zalmanlip/Camera-Trap/README.md

# Camera-Trap
refer to https://github.com/anamitradatta/Integrated-Camera-Trap for more details of the project

For info on work by me, email zalman9876@gmail.com with the subject line "Camera Trap"
