zalmanlip/Camera-Trap/Integrated-Camera-Trap-master/README.md

Integrated-Camera-Trap

Senior Design Project 2020 Team 15

Members: <br />
Anamitra Datta  <br />
Max Haimowitz <br />
Xiaoyang Pan <br />
Minting Chen <br />

Advisors: <br />
Professor Duncan Irschick: (https://www.bio.umass.edu/biology/about/directories/faculty/duncan-j-irschick) <br />
Professor David Schmidt: (https://mie.umass.edu/faculty/david-schmidt) <br />
Professor Marco Duarte (ECE SDP Advisor) : (https://ece.umass.edu/faculty/marco-duarte) <br />

http://www.ecs.umass.edu/ece/sdp/sdp20/team15/

Network of Raspberry Pis connected with Camera Modules to take synchronized pictures via WIFI using Message Query Telemetry Transport (MQTT) (Mosquitto) triggered by motion sensors

If you need access to this repository, contact me at my email address: anamitradatta@gmail.com and cc Professor Duncan 
Irschick and/or Professor David Schmidt and ask them to grant permission. Please provide your github username as well.
