zalmanlip/Camera-Trap/BOM.xlsx

 | Description | Source | Part number | QTY to Order | Price | Link | QTY per Unit | For one enclosure | cost for 1 enclosure | Enough to make
1 | High-Temperature Silicone Rubber Tubing for Air and Water - Soft, Durometer 35A, 1/8" ID, 1/4" OD, Opaque White | McMaster-Carr | 5236K506 | 1 | $13.70 | https://www.mcmaster.com/catalog/5236k506 | 10 | 2 | $2.74 | 5
2 | Heat-Set Inserts for Plastic, Brass, M2.5 x 0.45 mm, 5.9 mm Installed Length | McMaster-Carr | 94459A439 | 1 | $8.28 | https://www.mcmaster.com/catalog/94459a439 | 25 | 6 | $1.99 | 4
3 | 18-8 Stainless Steel Hex Head Screw, M4 x 0.7 mm Thread, 30 mm Long | McMaster-Carr | 91287A118 | 1 | $9.32 | https://www.mcmaster.com/catalog/91287a118 | 50 | 2 | $0.37 | 25
4 | 18-8 Stainless Steel Wing Nut,M4 x 0.7 mm Thread | McMaster-Carr | 94545A220 | 1 | $7.00 | https://www.mcmaster.com/catalog/94545a220 | 10 | 2 | $1.40 | 5
5 | General Purpose 18-8 Stainless Steel Washer,for M4 Screw Size, 4.300 mm ID, 8 mm OD | McMaster-Carr | 98689A113 | 1 | $2.86 | https://www.mcmaster.com/catalog/98689a113 | 100 | 4 | $0.11 | 25
6 | 3M Super Silicone Sealant, Model 8661, 3 oz. Tube | McMaster-Carr | 74955A53 | 1 | $13.22 | https://www.mcmaster.com/catalog/74955a53 | 1 | 0.1 | $1.32 | 10
7 | Black-Oxide Alloy Steel Socket Head Screw, M2.5 x 0.45 mm Thread, 4 mm Long | McMaster-Carr | 91290A099 | 1 | $10.45 | https://www.mcmaster.com/catalog/91290a099 | 50 | 6 | $1.25 | 8
8 | Partially Threaded Steel Stud, M3 x 0.50 mm Thread Size, 10 mm Long | McMaster-Carr | 97493A112 | 1 | $7.29 | https://www.mcmaster.com/catalog/97493a112 | 25 | 8 | $2.33 | 3
9 | Light-Duty Buckles for 1" Maximum Webbing Width, Sew-on, Plastic Feed Through Part number | McMaster-Carr | 29705T81 | 1 | $7.56 | https://www.mcmaster.com/catalog/29705t81 | 25 | 1 | $0.30 | 25
10 | Zinc-Plated Alloy Steel Socket Head Screw, M2 x 0.4 mm Thread, 5 mm Long | McMaster-Carr | 90128A177 | 1 | $12.40 | https://www.mcmaster.com/catalog/90128a177 | 100 | 6 | $0.74 | 16
11 | Shock-Absorbing Nylon Webbing, 1" Wide, 4 Feet Long, Black | McMaster-Carr | 3510T54 | 1 | $6.29 | https://www.mcmaster.com/catalog/3510t54 | 2 | 1 | $3.15 | 2
12 | HATCHBOX PLA 3D Printer Filament, Dimensional Accuracy +/- 0.03 mm, 1 kg Spool, 1.75 mm, White | Amazon |  | 1 | $22.99 | https://www.amazon.com/dp/B00J0GMMP6/ref=pe_386300_440135490_TE_item | 1 | 0.5 | $11.49 | 2
 |  |  |  |  |  |  |  | Per unit cost: | $27.21
 |  |  |  |  | h
