zalmanlip/Camera-Trap/CAD/Mount.SLDPRT

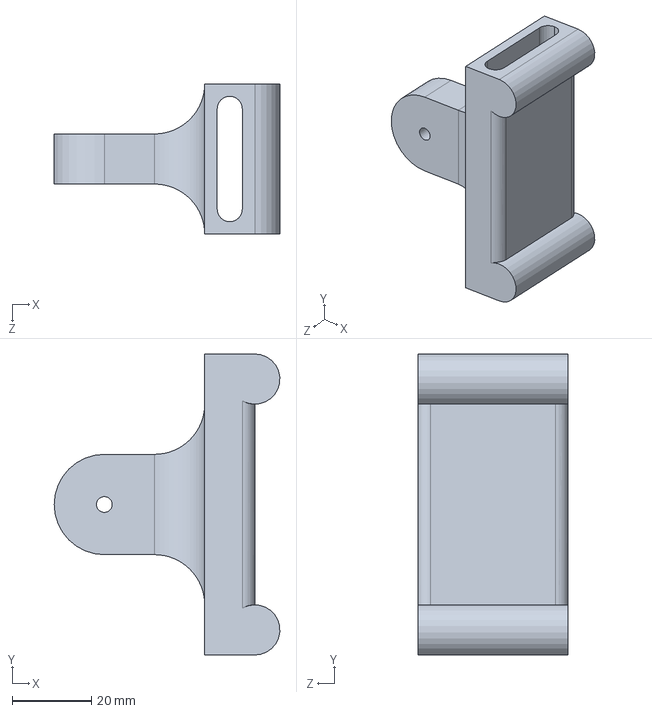
[picture p12: CAD file, 2021-12-16]
CAD/Mount.SLDPRT
57.1 x 76.2 x 38.1 mm
