zalmanlip/Camera-Trap/CAD/Swivel.SLDPRT

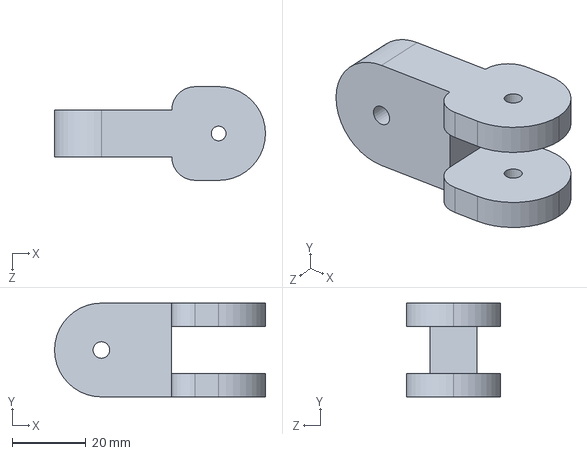
[picture p13: CAD file, 2021-12-16]
CAD/Swivel.SLDPRT
57.2 x 25.4 x 25.4 mm
