zalmanlip/Camera-Trap/CAD/HCSR501.step

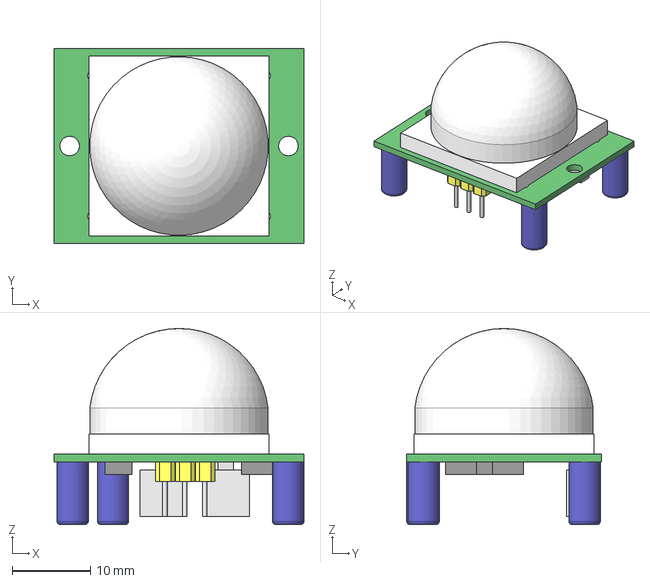
[picture p14: CAD file, 2021-12-16]
CAD/HCSR501.step
32.0 x 25.0 x 25.1 mm
