zalmanlip/Camera-Trap/CAD/Latch.SLDPRT

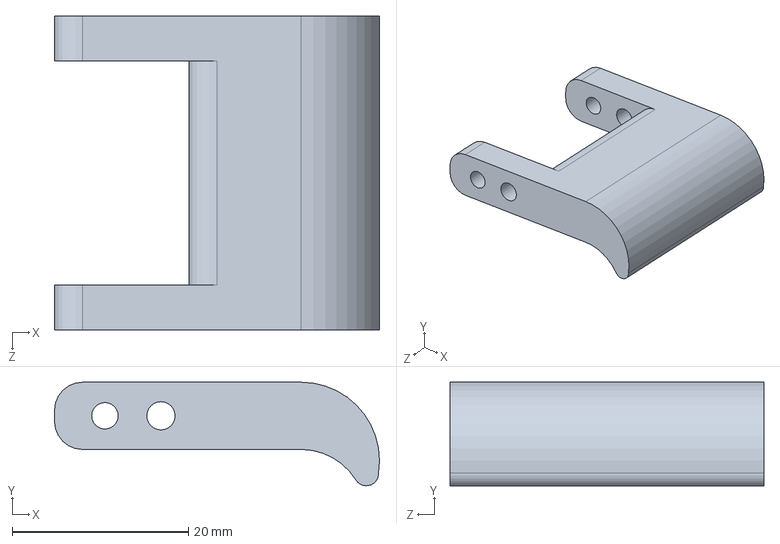
[picture p15: CAD file, 2021-12-16]
CAD/Latch.SLDPRT
36.8 x 11.7 x 35.6 mm
