zalmanlip/Camera-Trap/CAD/Camera Bracket.SLDPRT

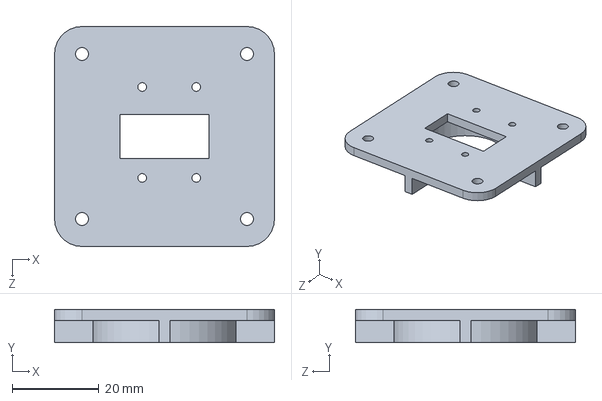
[picture p16: CAD file, 2021-12-16]
CAD/Camera Bracket.SLDPRT
50.8 x 7.62 x 50.8 mm
