zalmanlip/Camera-Trap/CAD/Lid.SLDPRT

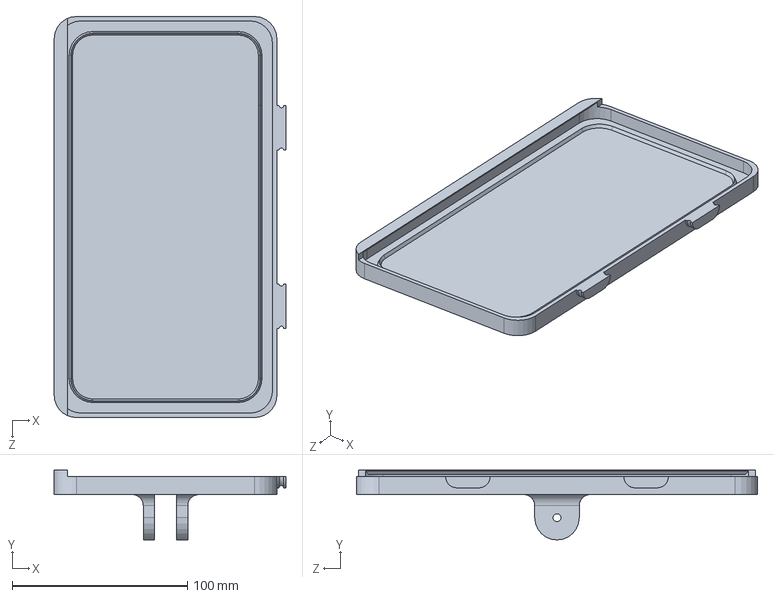
[picture p17: CAD file, 2021-12-16]
CAD/Lid.SLDPRT
132.1 x 39.9 x 228.6 mm
