zalmanlip/Camera-Trap/CAD/Separator.SLDPRT

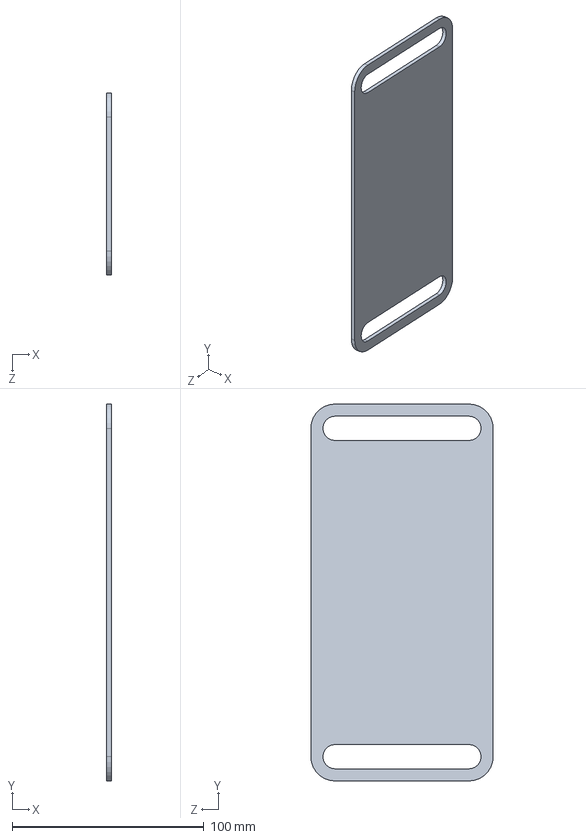
[picture p18: CAD file, 2021-12-16]
CAD/Separator.SLDPRT
2.54 x 196.9 x 95.2 mm
