zalmanlip/Camera-Trap/CAD/Hook.SLDPRT

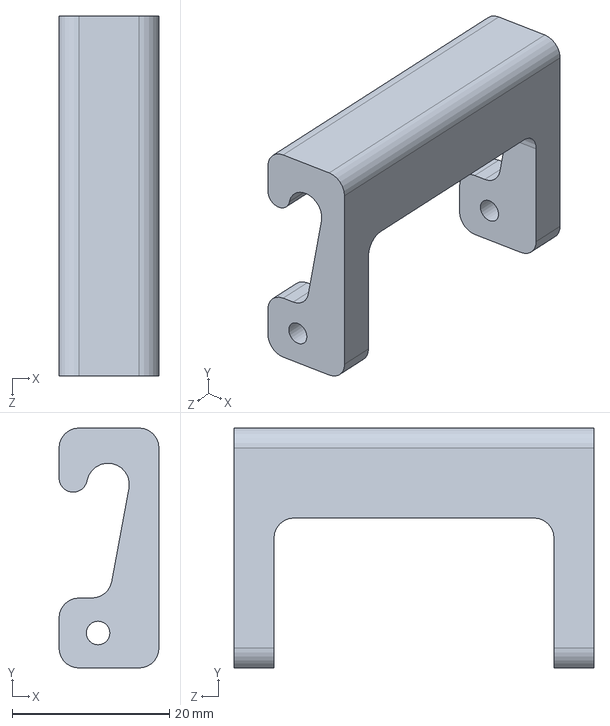
[picture p19: CAD file, 2021-12-16]
CAD/Hook.SLDPRT
12.7 x 30.5 x 45.7 mm
