zalmanlip/Camera-Trap/CAD/Battery Mockup.SLDPRT

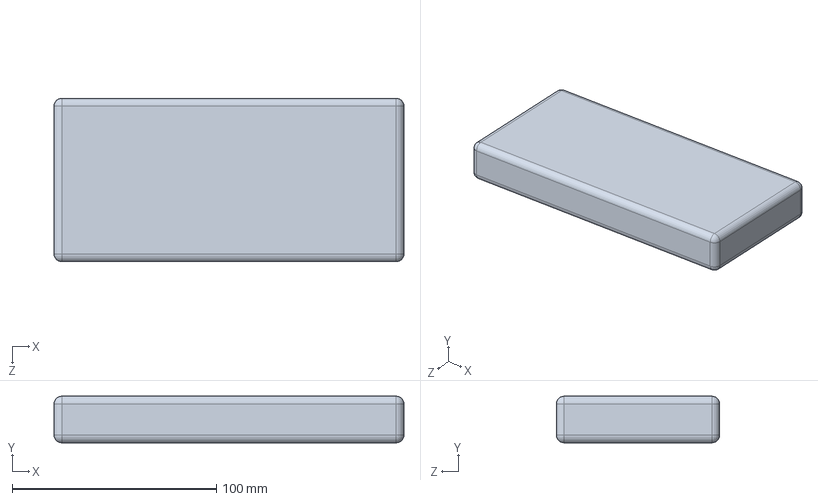
[picture p20: CAD file, 2021-12-16]
CAD/Battery Mockup.SLDPRT
171.4 x 22.9 x 80.0 mm
