zalmanlip/Camera-Trap/CAD/Case.SLDPRT

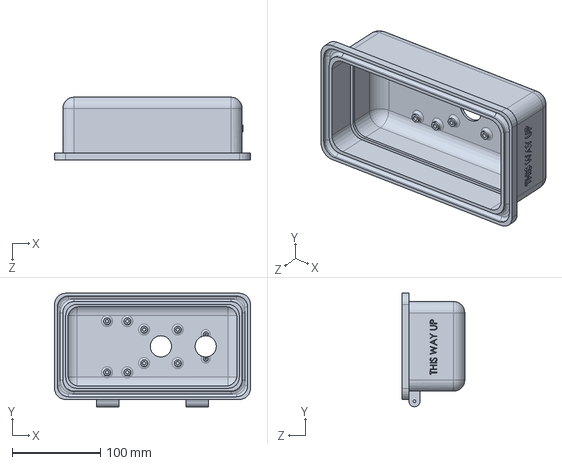
[picture p21: CAD file, 2021-12-16]
CAD/Case.SLDPRT
222.2 x 128.9 x 71.1 mm
