zalmanlip/Camera-Trap/CAD/Cam V2.1 v1.step

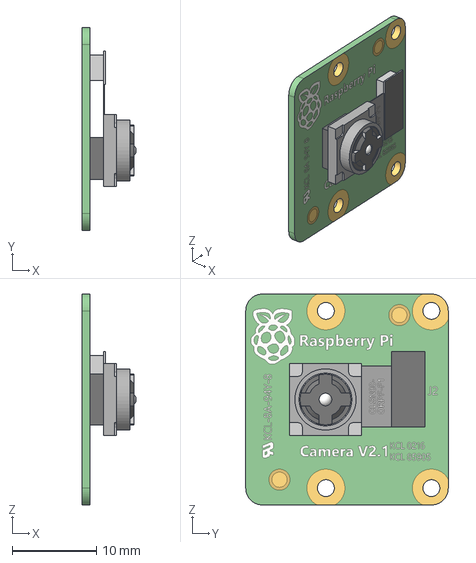
[picture p22: CAD file, 2021-12-16]
CAD/Cam V2.1 v1.step
6.45 x 24.0 x 25.0 mm
