zalmanlip/Camera-Trap/(list of files, cad)

Other CAD files:
Integrated-Camera-Trap-master/3d_models/SensorShell.f3d
Integrated-Camera-Trap-master/3d_models/enclosure.f3d
Integrated-Camera-Trap-master/Integrated-Camera-Trap-master/3d_models/SensorShell.f3d
Integrated-Camera-Trap-master/Integrated-Camera-Trap-master/3d_models/enclosure.f3d
